jtitton/RC-Light-Controller/LuzesArduino_Producao/LuzesArduino_Producao.ino

/*
 * ============================================================
 *  Sistema de Luzes para Carro RC - v8.4 (Versão PRODUÇÃO / PISTA)
 *  Arduino Nano + Receptor FlySky FS-BS6 + Acelerômetro MPU-6050
 * ============================================================
 *
 * Esta versão é 100% focada em PERFORMANCE MÁXIMA NA PISTA:
 *   - Zero comunicação Serial (sem desperdício de ciclos de CPU ou interrupções de UART).
 *   - Suporte a Acelerômetro I2C MPU-6050 nos pinos A4 (SDA) e A5 (SCL) a 400kHz.
 *   - Auto-Alinhamento Vetorial 3D (independente da orientação de montagem).
 *   - Alerta de Capotamento (Roll-Over Safety): 4 piscas piscam rápido em alerta.
 *   - Loop otimizado rodando entre 1.000 Hz e 2.000 Hz com MPU ativo (~20.000–30.000 Hz em fallback sem sensor).
 *   - Inicialização e Calibração 100% autônomas via rádio guiadas por LEDs.
 *
 * Entradas (Servo PPM do receptor):
 *   D4 - Volante / Direção (CH1, Pin Change Interrupt PCINT20)
 *   D2 - Acelerador / Freio (CH2, Interrupção externa INT0)
 *   D3 - Farol (CH4, Interrupção externa INT1)
 *   5V / GND - Alimentação direta via Canal 6 (CH6 do receptor)
 *
 * Interface I2C:
 *   A4 (SDA) - Dados I2C do MPU-6050 (GY-521)
 *   A5 (SCL) - Clock I2C do MPU-6050 (GY-521)
 *
 * Saídas (LEDs):
 *   D5  - Lanterna traseira (vermelho, PWM com fade suave de ~300ms)
 *   D6  - Luz de freio (vermelho, PWM com fade suave de ~300ms)
 *   D9  - Farol dianteiro (branco via Q1, PWM com fade suave: OFF / 40% / 100%)
 *   D10 - Pisca dianteiro esquerdo (laranja, Digital)
 *   D11 - Pisca dianteiro direito (laranja, Digital)
 *   D7  - Pisca traseiro esquerdo (laranja, Digital)
 *   D8  - Pisca traseiro direito (laranja, Digital)
 */

#include <EEPROM.h>
#include <Wire.h>

// ============================================================
// PINAGEM
// ============================================================
#define PIN_IN_STEERING    4    // CH1 - Volante (PCINT20)
#define PIN_IN_THROTTLE    2    // CH2 - Aceleração (INT0)
#define PIN_IN_HEADLIGHT   3    // CH4 - Farol (INT1)

#define PIN_OUT_TAIL       5    // PWM - Lanterna traseira
#define PIN_OUT_BRAKE      6    // PWM/Digital - Luz de freio
#define PIN_OUT_HEADLIGHT  9    // PWM - Farol dianteiro
#define PIN_OUT_BLINK_FL   10   // Pisca dianteiro esquerdo
#define PIN_OUT_BLINK_FR   11   // Pisca dianteiro direito
#define PIN_OUT_BLINK_RL   7    // Pisca traseiro esquerdo
#define PIN_OUT_BLINK_RR   8    // Pisca traseiro direito

// ============================================================
// CONSTANTES E CONFIGURAÇÕES
// ============================================================
#define EEPROM_MAGIC_VALUE       0xAD
#define EEPROM_START_ADDR        0

#define PPM_VALID_MIN            800
#define PPM_VALID_MAX            2200

#define DEFAULT_CENTER           1500
#define DEFAULT_DEFLECTION       500

// --- Registradores e Constantes MPU-6050 (I2C) ---
#define MPU6050_ADDR_A           0x68
#define MPU6050_ADDR_B           0x69
#define MPU6050_REG_PWR_1        0x6B
#define MPU6050_REG_CONFIG       0x1A
#define MPU6050_REG_ACCEL_CFG    0x1C
#define MPU6050_REG_ACCEL_X      0x3B
#define ACCEL_SCALE_4G           8192.0f
#define ACCEL_BRAKE_THRESH_G     0.20f   // Desaceleração física para acionar freio
#define ACCEL_ROLLOVER_COS       0.15f   // Ângulo > 81° com a vertical indica capotamento

// --- Limiares de Ação (%) ---
#define STEERING_BLINK_PERCENT   70    // Deflexão do volante para ligar o pisca (70%)
#define THROTTLE_BRAKE_PERCENT   5     // Desaceleração PPM para acionar freio (5%)
#define HEADLIGHT_THRESH_LOW     33    // Abaixo: OFF | Acima: 40%
#define HEADLIGHT_THRESH_HIGH    66    // Acima: 100%

// --- Níveis de Brilho (PWM 0-255) ---
#define BRIGHTNESS_OFF           0
#define BRIGHTNESS_40            102
#define BRIGHTNESS_100           255

// --- Pisca e Fade ---
#define BLINK_INTERVAL_MS        250   // 120 bpm
#define BLINK_HAZARD_MS          120   // Pisca-alerta de capotamento
#define FADE_STEP_INTERVAL_MS    6     // Intervalo de fade da lanterna (~300ms total)
#define FADE_STEP_SIZE           5

// --- Filtro de Média Móvel ---
#define FILTER_SIZE              5
#define CAL_MIN_RANGE            200

// ============================================================
// ESTRUTURAS
// ============================================================
struct CalibrationData {
  uint8_t magic;
  int steerDeflLeft;
  int steerDeflRight;
  int throDeflBack;
  int throDeflFwd;
  int headlightMin;
  int headlightMax;
  // Vetor unitário longitudinal de avanço 3D
  float uLongX;
  float uLongY;
  float uLongZ;
};

struct MovingAvgFilter {
  int samples[FILTER_SIZE];
  int index;

  void init(int defaultVal) {
    for (int i = 0; i < FILTER_SIZE; i++) samples[i] = defaultVal;
    index = 0;
  }

  int update(int newValue) {
    samples[index] = newValue;
    index = (index + 1) % FILTER_SIZE;
    return average();
  }

  int average() const {
    long sum = 0;
    for (int i = 0; i < FILTER_SIZE; i++) sum += samples[i];
    return (int)(sum / FILTER_SIZE);
  }
};

enum HeadlightMode { HL_OFF, HL_DIM, HL_FULL };
enum BlinkDirection {
  BLINK_HAZARD = -2,
  BLINK_LEFT   = -1,
  BLINK_NONE   =  0,
  BLINK_RIGHT  =  1
};

// ============================================================
// VARIÁVEIS GLOBAIS
// ============================================================
CalibrationData g_cal;

int g_steerCenter = DEFAULT_CENTER;
int g_throCenter  = DEFAULT_CENTER;

// Acelerômetro I2C & Força G
bool    g_hasMPU           = false;
uint8_t g_mpuAddr          = MPU6050_ADDR_A;
float   g_g0X              = 0.0f;
float   g_g0Y              = 0.0f;
float   g_g0Z              = 1.0f;
float   g_rawAx            = 0.0f;
float   g_rawAy            = 0.0f;
float   g_rawAz            = 1.0f;
float   g_accelLong        = 0.0f;
bool    g_rollOver         = false;
bool    g_longVectorLocked = false;

// ISR variables (volatile)
volatile unsigned long g_steerRiseTime = 0;
volatile unsigned long g_throRiseTime  = 0;
volatile unsigned long g_hlRiseTime    = 0;

volatile int g_steerPulse = DEFAULT_CENTER;
volatile int g_throPulse  = DEFAULT_CENTER;
volatile int g_hlPulse    = DEFAULT_CENTER;

volatile bool g_steerNewPulse = false;
volatile bool g_throNewPulse  = false;
volatile bool g_hlNewPulse    = false;

MovingAvgFilter g_steerFilter;
MovingAvgFilter g_throFilter;
MovingAvgFilter g_hlFilter;

// --- Fade suave dos LEDs (Farol Q1, Lanterna Traseira, Luz de Freio) ---
int           g_tailCurrent        = 0;
int           g_tailTarget         = 0;
unsigned long g_lastFadeUpdate     = 0;

int           g_hlCurrent          = 0;
int           g_hlTarget           = 0;
unsigned long g_lastHlFadeUpdate   = 0;

int           g_brakeCurrent       = 0;
int           g_brakeTarget        = 0;
unsigned long g_lastBrakeFadeUpdate = 0;

unsigned long g_lastBlinkToggle = 0;
bool          g_blinkState      = false;

HeadlightMode g_hlMode = HL_OFF;

// ============================================================
// PROTÓTIPOS
// ============================================================
void throttleISR();
void headlightISR();
int steeringToPercent(int ppm);
int throttleToPercent(int ppm);
int headlightToPercent(int ppm);
void allLEDsOff();
void blinkAllLEDs(int count, int intervalMs);
bool loadCalibration();
void saveCalibration();
void autoCenter();
bool checkCalibrationGesture();
void runFullCalibration();
int getFilteredSteering();
int getFilteredThrottle();
int getFilteredHeadlight();
HeadlightMode calcHeadlightMode(int hlPercent);
bool isBraking(int throPct, float accelLong);
BlinkDirection getBlinkDirection(int steerPct, bool rollOver);
void setHeadlightTarget(HeadlightMode mode);
void updateHeadlightFade();
void setTailLightTarget(HeadlightMode hlMode, bool braking);
void updateTailLightFade();
void setBrakeLightTarget(bool braking);
void updateBrakeLightFade();
void updateBlinkers(BlinkDirection direction);

bool initMPU6050();
bool readMPU6050(float &ax, float &ay, float &az);
void calibrateStaticGravity();
void updateLongitudinalVector(float ax, float ay, float az);
void processInertialDynamics(float ax, float ay, float az);

// ============================================================
// INTERRUPÇÕES
// ============================================================
ISR(PCINT2_vect) {
  if (PIND & (1 << PIN_IN_STEERING)) {
    g_steerRiseTime = micros();
  } else {
    unsigned long pw = micros() - g_steerRiseTime;
    if (pw >= PPM_VALID_MIN && pw <= PPM_VALID_MAX) {
      g_steerPulse = (int)pw;
      g_steerNewPulse = true;
    }
  }
}

void throttleISR() {
  if (PIND & (1 << PIN_IN_THROTTLE)) {
    g_throRiseTime = micros();
  } else {
    unsigned long pw = micros() - g_throRiseTime;
    if (pw >= PPM_VALID_MIN && pw <= PPM_VALID_MAX) {
      g_throPulse = (int)pw;
      g_throNewPulse = true;
    }
  }
}

void headlightISR() {
  if (PIND & (1 << PIN_IN_HEADLIGHT)) {
    g_hlRiseTime = micros();
  } else {
    unsigned long pw = micros() - g_hlRiseTime;
    if (pw >= PPM_VALID_MIN && pw <= PPM_VALID_MAX) {
      g_hlPulse = (int)pw;
      g_hlNewPulse = true;
    }
  }
}

// ============================================================
// DETECÇÃO DE GESTO NO BOOT
// ============================================================
bool checkCalibrationGesture() {
  digitalWrite(PIN_OUT_BLINK_FL, HIGH);
  digitalWrite(PIN_OUT_BLINK_FR, HIGH);

  int steerDeflectedCount = 0;
  int totalSamples = 0;
  unsigned long start = millis();

  // Limpa quaisquer flags pendentes
  noInterrupts();
  g_steerNewPulse = false;
  g_throNewPulse = false;
  interrupts();

  while (millis() - start < 1500) {
    int s = -1;
    noInterrupts();
    if (g_steerNewPulse) {
      s = g_steerPulse;
      g_steerNewPulse = false;
    }
    interrupts();

    if (s >= PPM_VALID_MIN && s <= PPM_VALID_MAX) {
      totalSamples++;
      if (s < 1250 || s > 1750) {
        steerDeflectedCount++;
      }
    }
    delay(10);
  }

  digitalWrite(PIN_OUT_BLINK_FL, LOW);
  digitalWrite(PIN_OUT_BLINK_FR, LOW);

  if (totalSamples >= 15 && steerDeflectedCount >= (totalSamples * 6 / 10)) {
    return true;
  }
  return false;
}

// ============================================================
// SETUP
// ============================================================
void setup() {
  pinMode(PIN_IN_STEERING,  INPUT);
  pinMode(PIN_IN_THROTTLE,  INPUT);
  pinMode(PIN_IN_HEADLIGHT, INPUT);

  pinMode(PIN_OUT_TAIL,      OUTPUT);
  pinMode(PIN_OUT_BRAKE,     OUTPUT);
  pinMode(PIN_OUT_HEADLIGHT, OUTPUT);
  pinMode(PIN_OUT_BLINK_FL,  OUTPUT);
  pinMode(PIN_OUT_BLINK_FR,  OUTPUT);
  pinMode(PIN_OUT_BLINK_RL,  OUTPUT);
  pinMode(PIN_OUT_BLINK_RR,  OUTPUT);

  allLEDsOff();

  g_steerFilter.init(DEFAULT_CENTER);
  g_throFilter.init(DEFAULT_CENTER);
  g_hlFilter.init(DEFAULT_CENTER - DEFAULT_DEFLECTION);

  // Configura interrupções por hardware
  PCICR |= (1 << PCIE2);
  PCMSK2 |= (1 << PCINT20);

  attachInterrupt(digitalPinToInterrupt(PIN_IN_THROTTLE),  throttleISR,  CHANGE);
  attachInterrupt(digitalPinToInterrupt(PIN_IN_HEADLIGHT), headlightISR, CHANGE);

  // Inicializa Acelerômetro MPU-6050
  if (initMPU6050()) {
    calibrateStaticGravity();
  }

  // Carrega calibração prévia ou usa padrões de fábrica (500us)
  if (!loadCalibration()) {
    g_cal.steerDeflLeft  = DEFAULT_DEFLECTION;
    g_cal.steerDeflRight = DEFAULT_DEFLECTION;
    g_cal.throDeflBack   = DEFAULT_DEFLECTION;
    g_cal.throDeflFwd    = DEFAULT_DEFLECTION;
    g_cal.headlightMin   = DEFAULT_CENTER - DEFAULT_DEFLECTION;
    g_cal.headlightMax   = DEFAULT_CENTER + DEFAULT_DEFLECTION;
    g_cal.uLongX         = 1.0f;
    g_cal.uLongY         = 0.0f;
    g_cal.uLongZ         = 0.0f;
  }

  // Verifica gesto de calibração no boot (volante virado por 1.5s)
  bool gesture = checkCalibrationGesture();

  if (gesture) {
    blinkAllLEDs(3, 100); // 3 piscadas confirmam entrada no modo calibração
    delay(400);
    runFullCalibration(); // Executa calibração autônoma guiada por LEDs
  } else {
    autoCenter();
    blinkAllLEDs(2, 100); // 2 piscadas confirmam pronto para rodar
  }
}

// ============================================================
// LOOP PRINCIPAL (Ultra-rápido, não-bloqueante: ~1–2 kHz com MPU, ~20–30 kHz em fallback)
// ============================================================
void loop() {
  int steerRaw = getFilteredSteering();
  int throRaw  = getFilteredThrottle();
  int hlRaw    = getFilteredHeadlight();

  // Lê aceleração inercial se o MPU-6050 estiver presente
  if (g_hasMPU) {
    float ax, ay, az;
    if (readMPU6050(ax, ay, az)) {
      g_rawAx = ax; g_rawAy = ay; g_rawAz = az;
      processInertialDynamics(ax, ay, az);
    }
  }

  int steerPct = steeringToPercent(steerRaw);
  int throPct  = throttleToPercent(throRaw);
  int hlPct    = headlightToPercent(hlRaw);

  // Auto-aprendizado do vetor longitudinal no primeiro avanço forte (>60%)
  if (g_hasMPU && throPct > 60 && !g_longVectorLocked) {
    updateLongitudinalVector(g_rawAx, g_rawAy, g_rawAz);
  }

  g_hlMode = calcHeadlightMode(hlPct);
  bool           braking  = isBraking(throPct, g_accelLong);
  BlinkDirection blinkDir = getBlinkDirection(steerPct, g_rollOver);

  setHeadlightTarget(g_hlMode);
  updateHeadlightFade();
  setTailLightTarget(g_hlMode, braking);
  updateTailLightFade();
  setBrakeLightTarget(braking);
  updateBrakeLightFade();
  updateBlinkers(blinkDir);
}

// ============================================================
// CONVERSÕES PERCENTUAIS
// ============================================================
int steeringToPercent(int ppm) {
  int deviation = ppm - g_steerCenter;
  if (deviation >= 0) {
    if (g_cal.steerDeflRight <= 0) return 0;
    return constrain((int)((long)deviation * 100 / g_cal.steerDeflRight), 0, 100);
  } else {
    if (g_cal.steerDeflLeft <= 0) return 0;
    return constrain((int)((long)deviation * 100 / g_cal.steerDeflLeft), -100, 0);
  }
}

int throttleToPercent(int ppm) {
  int deviation = ppm - g_throCenter;
  if (deviation >= 0) {
    if (g_cal.throDeflFwd <= 0) return 0;
    return constrain((int)((long)deviation * 100 / g_cal.throDeflFwd), 0, 100);
  } else {
    if (g_cal.throDeflBack <= 0) return 0;
    return constrain((int)((long)deviation * 100 / g_cal.throDeflBack), -100, 0);
  }
}

int headlightToPercent(int ppm) {
  int range = g_cal.headlightMax - g_cal.headlightMin;
  if (range <= 0) return 0;
  return constrain((int)((long)(ppm - g_cal.headlightMin) * 100 / range), 0, 100);
}

// ============================================================
// CONTROLE DOS LEDS
// ============================================================
void allLEDsOff() {
  analogWrite(PIN_OUT_HEADLIGHT, 0);
  analogWrite(PIN_OUT_TAIL, 0);
  analogWrite(PIN_OUT_BRAKE, 0);
  digitalWrite(PIN_OUT_BLINK_FL, LOW);
  digitalWrite(PIN_OUT_BLINK_FR, LOW);
  digitalWrite(PIN_OUT_BLINK_RL, LOW);
  digitalWrite(PIN_OUT_BLINK_RR, LOW);
  g_tailCurrent  = 0;
  g_tailTarget   = 0;
  g_hlCurrent    = 0;
  g_hlTarget     = 0;
  g_brakeCurrent = 0;
  g_brakeTarget  = 0;
}

void blinkAllLEDs(int count, int intervalMs) {
  for (int i = 0; i < count; i++) {
    digitalWrite(PIN_OUT_BLINK_FL, HIGH);
    digitalWrite(PIN_OUT_BLINK_FR, HIGH);
    digitalWrite(PIN_OUT_BLINK_RL, HIGH);
    digitalWrite(PIN_OUT_BLINK_RR, HIGH);
    analogWrite(PIN_OUT_HEADLIGHT, BRIGHTNESS_100);
    analogWrite(PIN_OUT_TAIL, BRIGHTNESS_100);
    analogWrite(PIN_OUT_BRAKE, BRIGHTNESS_100);
    delay(intervalMs);
    allLEDsOff();
    delay(intervalMs);
  }
}

int getFilteredSteering() {
  noInterrupts();
  if (g_steerNewPulse) {
    int val = g_steerPulse;
    g_steerNewPulse = false;
    interrupts();
    return g_steerFilter.update(val);
  }
  interrupts();
  return g_steerFilter.average();
}

int getFilteredThrottle() {
  noInterrupts();
  if (g_throNewPulse) {
    int val = g_throPulse;
    g_throNewPulse = false;
    interrupts();
    return g_throFilter.update(val);
  }
  interrupts();
  return g_throFilter.average();
}

int getFilteredHeadlight() {
  noInterrupts();
  if (g_hlNewPulse) {
    int val = g_hlPulse;
    g_hlNewPulse = false;
    interrupts();
    return g_hlFilter.update(val);
  }
  interrupts();
  return g_hlFilter.average();
}

HeadlightMode calcHeadlightMode(int hlPercent) {
  if (hlPercent < HEADLIGHT_THRESH_LOW)  return HL_OFF;
  if (hlPercent < HEADLIGHT_THRESH_HIGH) return HL_DIM;
  return HL_FULL;
}

bool isBraking(int throPct, float accelLong) {
  if (throPct > THROTTLE_BRAKE_PERCENT) return false;
  if (throPct < -THROTTLE_BRAKE_PERCENT) return true;
  if (g_hasMPU && accelLong < -ACCEL_BRAKE_THRESH_G) return true;
  return false;
}

BlinkDirection getBlinkDirection(int steerPct, bool rollOver) {
  if (rollOver) return BLINK_HAZARD;
  if (steerPct <= -STEERING_BLINK_PERCENT) return BLINK_LEFT;
  if (steerPct >=  STEERING_BLINK_PERCENT) return BLINK_RIGHT;
  return BLINK_NONE;
}

void setHeadlightTarget(HeadlightMode mode) {
  switch (mode) {
    case HL_OFF:  g_hlTarget = BRIGHTNESS_OFF; break;
    case HL_DIM:  g_hlTarget = BRIGHTNESS_40;  break;
    case HL_FULL: g_hlTarget = BRIGHTNESS_100; break;
  }
}

void updateHeadlightFade() {
  if (g_hlCurrent == g_hlTarget) return;

  unsigned long now = millis();
  if (now - g_lastHlFadeUpdate < FADE_STEP_INTERVAL_MS) return;
  g_lastHlFadeUpdate = now;

  if (g_hlCurrent < g_hlTarget) {
    g_hlCurrent += FADE_STEP_SIZE;
    if (g_hlCurrent > g_hlTarget) g_hlCurrent = g_hlTarget;
  } else if (g_hlCurrent > g_hlTarget) {
    g_hlCurrent -= FADE_STEP_SIZE;
    if (g_hlCurrent < g_hlTarget) g_hlCurrent = g_hlTarget;
  }
  analogWrite(PIN_OUT_HEADLIGHT, g_hlCurrent);
}

void setTailLightTarget(HeadlightMode hlMode, bool braking) {
  if (braking) {
    g_tailTarget = BRIGHTNESS_100;
  } else if (hlMode != HL_OFF) {
    g_tailTarget = BRIGHTNESS_40;
  } else {
    g_tailTarget = BRIGHTNESS_OFF;
  }
}

void updateTailLightFade() {
  unsigned long now = millis();
  if (now - g_lastFadeUpdate < FADE_STEP_INTERVAL_MS) return;
  g_lastFadeUpdate = now;

  if (g_tailCurrent < g_tailTarget) {
    g_tailCurrent += FADE_STEP_SIZE;
    if (g_tailCurrent > g_tailTarget) g_tailCurrent = g_tailTarget;
  } else if (g_tailCurrent > g_tailTarget) {
    g_tailCurrent -= FADE_STEP_SIZE;
    if (g_tailCurrent < g_tailTarget) g_tailCurrent = g_tailTarget;
  }
  analogWrite(PIN_OUT_TAIL, g_tailCurrent);
}

void setBrakeLightTarget(bool braking) {
  g_brakeTarget = braking ? BRIGHTNESS_100 : BRIGHTNESS_OFF;
}

void updateBrakeLightFade() {
  if (g_brakeCurrent == g_brakeTarget) return;

  unsigned long now = millis();
  if (now - g_lastBrakeFadeUpdate < FADE_STEP_INTERVAL_MS) return;
  g_lastBrakeFadeUpdate = now;

  if (g_brakeCurrent < g_brakeTarget) {
    g_brakeCurrent += FADE_STEP_SIZE;
    if (g_brakeCurrent > g_brakeTarget) g_brakeCurrent = g_brakeTarget;
  } else if (g_brakeCurrent > g_brakeTarget) {
    g_brakeCurrent -= FADE_STEP_SIZE;
    if (g_brakeCurrent < g_brakeTarget) g_brakeCurrent = g_brakeTarget;
  }
  analogWrite(PIN_OUT_BRAKE, g_brakeCurrent);
}

void updateBlinkers(BlinkDirection direction) {
  unsigned long now = millis();
  if (direction == BLINK_NONE) {
    digitalWrite(PIN_OUT_BLINK_FL, LOW);
    digitalWrite(PIN_OUT_BLINK_FR, LOW);
    digitalWrite(PIN_OUT_BLINK_RL, LOW);
    digitalWrite(PIN_OUT_BLINK_RR, LOW);
    g_blinkState = false;
    g_lastBlinkToggle = now;
    return;
  }

  unsigned long interval = (direction == BLINK_HAZARD) ? BLINK_HAZARD_MS : BLINK_INTERVAL_MS;

  if (now - g_lastBlinkToggle >= interval) {
    g_blinkState = !g_blinkState;
    g_lastBlinkToggle = now;
  }

  if (direction == BLINK_HAZARD) {
    digitalWrite(PIN_OUT_BLINK_FL, g_blinkState ? HIGH : LOW);
    digitalWrite(PIN_OUT_BLINK_RL, g_blinkState ? HIGH : LOW);
    digitalWrite(PIN_OUT_BLINK_FR, g_blinkState ? HIGH : LOW);
    digitalWrite(PIN_OUT_BLINK_RR, g_blinkState ? HIGH : LOW);
  } else if (direction == BLINK_LEFT) {
    digitalWrite(PIN_OUT_BLINK_FL, g_blinkState ? HIGH : LOW);
    digitalWrite(PIN_OUT_BLINK_RL, g_blinkState ? HIGH : LOW);
    digitalWrite(PIN_OUT_BLINK_FR, LOW);
    digitalWrite(PIN_OUT_BLINK_RR, LOW);
  } else {
    digitalWrite(PIN_OUT_BLINK_FL, LOW);
    digitalWrite(PIN_OUT_BLINK_RL, LOW);
    digitalWrite(PIN_OUT_BLINK_FR, g_blinkState ? HIGH : LOW);
    digitalWrite(PIN_OUT_BLINK_RR, g_blinkState ? HIGH : LOW);
  }
}

// ============================================================
// ACELERÔMETRO MPU-6050 & VETOR 3D (ZERO SERIAL)
// ============================================================
bool initMPU6050() {
  Wire.begin();
  Wire.setClock(400000);

  g_mpuAddr = MPU6050_ADDR_A;
  Wire.beginTransmission(g_mpuAddr);
  byte error = Wire.endTransmission();

  if (error != 0) {
    g_mpuAddr = MPU6050_ADDR_B;
    Wire.beginTransmission(g_mpuAddr);
    error = Wire.endTransmission();
  }

  if (error != 0) {
    g_hasMPU = false;
    return false;
  }

  Wire.beginTransmission(g_mpuAddr);
  Wire.write(MPU6050_REG_PWR_1);
  Wire.write(0x00);
  Wire.endTransmission();

  Wire.beginTransmission(g_mpuAddr);
  Wire.write(MPU6050_REG_CONFIG);
  Wire.write(0x03);
  Wire.endTransmission();

  Wire.beginTransmission(g_mpuAddr);
  Wire.write(MPU6050_REG_ACCEL_CFG);
  Wire.write(0x08);
  Wire.endTransmission();

  g_hasMPU = true;
  return true;
}

bool readMPU6050(float &ax, float &ay, float &az) {
  if (!g_hasMPU) return false;

  Wire.beginTransmission(g_mpuAddr);
  Wire.write(MPU6050_REG_ACCEL_X);
  if (Wire.endTransmission(false) != 0) return false;

  Wire.requestFrom((uint8_t)g_mpuAddr, (uint8_t)6, (uint8_t)true);
  if (Wire.available() < 6) return false;

  int16_t rawX = (int16_t)(Wire.read() << 8 | Wire.read());
  int16_t rawY = (int16_t)(Wire.read() << 8 | Wire.read());
  int16_t rawZ = (int16_t)(Wire.read() << 8 | Wire.read());

  ax = (float)rawX / ACCEL_SCALE_4G;
  ay = (float)rawY / ACCEL_SCALE_4G;
  az = (float)rawZ / ACCEL_SCALE_4G;
  return true;
}

void calibrateStaticGravity() {
  if (!g_hasMPU) return;
  float sumX = 0, sumY = 0, sumZ = 0;
  int count = 0;
  unsigned long t0 = millis();

  while (millis() - t0 < 800) {
    float ax, ay, az;
    if (readMPU6050(ax, ay, az)) {
      sumX += ax;
      sumY += ay;
      sumZ += az;
      count++;
    }
    delay(10);
  }

  if (count >= 10) {
    g_g0X = sumX / count;
    g_g0Y = sumY / count;
    g_g0Z = sumZ / count;
  } else {
    g_g0X = 0.0f; g_g0Y = 0.0f; g_g0Z = 1.0f;
  }
}

void updateLongitudinalVector(float ax, float ay, float az) {
  float dx = ax - g_g0X;
  float dy = ay - g_g0Y;
  float dz = az - g_g0Z;
  float mag = sqrt(dx * dx + dy * dy + dz * dz);

  if (mag >= 0.25f) {
    g_cal.uLongX = dx / mag;
    g_cal.uLongY = dy / mag;
    g_cal.uLongZ = dz / mag;
    g_longVectorLocked = true;
    saveCalibration();
  }
}

void processInertialDynamics(float ax, float ay, float az) {
  if (!g_hasMPU) {
    g_accelLong = 0.0f;
    g_rollOver  = false;
    return;
  }

  float dx = ax - g_g0X;
  float dy = ay - g_g0Y;
  float dz = az - g_g0Z;
  g_accelLong = (dx * g_cal.uLongX) + (dy * g_cal.uLongY) + (dz * g_cal.uLongZ);

  float gMagAct = sqrt(ax * ax + ay * ay + az * az);
  float gMag0   = sqrt(g_g0X * g_g0X + g_g0Y * g_g0Y + g_g0Z * g_g0Z);

  if (gMagAct > 0.3f && gMag0 > 0.3f) {
    float cosAngle = (ax * g_g0X + ay * g_g0Y + az * g_g0Z) / (gMagAct * gMag0);
    g_rollOver = (cosAngle < ACCEL_ROLLOVER_COS);
  } else {
    g_rollOver = false;
  }
}

// ============================================================
// EEPROM
// ============================================================
bool loadCalibration() {
  EEPROM.get(EEPROM_START_ADDR, g_cal);
  if (g_cal.magic != EEPROM_MAGIC_VALUE) return false;
  if (g_cal.steerDeflLeft < 50 || g_cal.steerDeflRight < 50 ||
      g_cal.throDeflBack < 50  || g_cal.throDeflFwd < 50 ||
      (g_cal.headlightMax - g_cal.headlightMin) < CAL_MIN_RANGE) {
    return false;
  }
  float mag = sqrt(g_cal.uLongX * g_cal.uLongX + g_cal.uLongY * g_cal.uLongY + g_cal.uLongZ * g_cal.uLongZ);
  if (isnan(mag) || mag < 0.5f || mag > 1.5f) {
    g_cal.uLongX = 1.0f;
    g_cal.uLongY = 0.0f;
    g_cal.uLongZ = 0.0f;
    g_longVectorLocked = false;
  } else {
    g_longVectorLocked = true;
  }
  return true;
}

void saveCalibration() {
  g_cal.magic = EEPROM_MAGIC_VALUE;
  EEPROM.put(EEPROM_START_ADDR, g_cal);
}

// ============================================================
// AUTO-CENTRO E CALIBRAÇÃO GUIADA POR LEDS
// ============================================================
void autoCenter() {
  digitalWrite(PIN_OUT_BLINK_FL, HIGH);
  digitalWrite(PIN_OUT_BLINK_FR, HIGH);
  digitalWrite(PIN_OUT_BLINK_RL, HIGH);
  digitalWrite(PIN_OUT_BLINK_RR, HIGH);

  long steerSum = 0, throSum = 0;
  int  samples  = 0;
  unsigned long startTime = millis();

  noInterrupts();
  g_steerNewPulse = false;
  g_throNewPulse = false;
  interrupts();

  while (millis() - startTime < 2000) {
    int sVal = 0, tVal = 0;
    bool gotS = false, gotT = false;

    noInterrupts();
    if (g_steerNewPulse) { sVal = g_steerPulse; g_steerNewPulse = false; gotS = true; }
    if (g_throNewPulse)  { tVal = g_throPulse;  g_throNewPulse  = false; gotT = true; }
    interrupts();

    if (gotS && gotT) {
      steerSum += sVal;
      throSum  += tVal;
      samples++;
    }
    delay(5);
  }

  digitalWrite(PIN_OUT_BLINK_FL, LOW);
  digitalWrite(PIN_OUT_BLINK_FR, LOW);
  digitalWrite(PIN_OUT_BLINK_RL, LOW);
  digitalWrite(PIN_OUT_BLINK_RR, LOW);

  if (samples > 0) {
    g_steerCenter = (int)(steerSum / samples);
    g_throCenter  = (int)(throSum  / samples);
  } else {
    g_steerCenter = DEFAULT_CENTER;
    g_throCenter  = DEFAULT_CENTER;
  }
}

void runFullCalibration() {
  autoCenter();
  if (g_hasMPU) {
    calibrateStaticGravity();
  }
  blinkAllLEDs(2, 150);
  delay(300);

  // --- PASSO 1: EXTREMOS VOLANTE E ACELERADOR (5s) ---
  int sMin = g_steerCenter, sMax = g_steerCenter;
  int tMin = g_throCenter,  tMax = g_throCenter;
  unsigned long startTime = millis();
  bool ledTog = false;
  unsigned long lastLed = 0;

  noInterrupts();
  g_steerNewPulse = false;
  g_throNewPulse = false;
  interrupts();

  while (millis() - startTime < 5000) {
    int s = -1, t = -1;

    noInterrupts();
    if (g_steerNewPulse) { s = g_steerPulse; g_steerNewPulse = false; }
    if (g_throNewPulse)  { t = g_throPulse;  g_throNewPulse  = false; }
    interrupts();

    if (s > 0) { if (s < sMin) sMin = s; if (s > sMax) sMax = s; }
    if (t > 0) {
      if (t < tMin) tMin = t;
      if (t > tMax) tMax = t;
      if (g_hasMPU && (t - g_throCenter) > (g_cal.throDeflFwd / 2)) {
        float ax, ay, az;
        if (readMPU6050(ax, ay, az)) {
          updateLongitudinalVector(ax, ay, az);
        }
      }
    }

    // Piscas alternando esquerda/direita guiam o usuário
    if (millis() - lastLed >= 200) {
      ledTog = !ledTog;
      digitalWrite(PIN_OUT_BLINK_FL, ledTog ? HIGH : LOW);
      digitalWrite(PIN_OUT_BLINK_RL, ledTog ? HIGH : LOW);
      digitalWrite(PIN_OUT_BLINK_FR, ledTog ? LOW  : HIGH);
      digitalWrite(PIN_OUT_BLINK_RR, ledTog ? LOW  : HIGH);
      lastLed = millis();
    }
    delay(5);
  }
  allLEDsOff();

  g_cal.steerDeflLeft  = g_steerCenter - sMin;
  g_cal.steerDeflRight = sMax - g_steerCenter;
  g_cal.throDeflBack   = g_throCenter  - tMin;
  g_cal.throDeflFwd    = tMax - g_throCenter;

  if (g_cal.steerDeflLeft + g_cal.steerDeflRight < CAL_MIN_RANGE) {
    g_cal.steerDeflLeft  = DEFAULT_DEFLECTION;
    g_cal.steerDeflRight = DEFAULT_DEFLECTION;
  }
  if (g_cal.throDeflBack + g_cal.throDeflFwd < CAL_MIN_RANGE) {
    g_cal.throDeflBack   = DEFAULT_DEFLECTION;
    g_cal.throDeflFwd    = DEFAULT_DEFLECTION;
  }

  blinkAllLEDs(2, 150);
  delay(300);

  // --- PASSO 2: FAROL (5s) ---
  g_cal.headlightMin = PPM_VALID_MAX;
  g_cal.headlightMax = PPM_VALID_MIN;

  analogWrite(PIN_OUT_HEADLIGHT, BRIGHTNESS_40);

  noInterrupts();
  g_hlNewPulse = false;
  interrupts();

  startTime = millis();
  while (millis() - startTime < 5000) {
    int h = -1;

    noInterrupts();
    if (g_hlNewPulse) { h = g_hlPulse; g_hlNewPulse = false; }
    interrupts();

    if (h > 0) {
      if (h < g_cal.headlightMin) g_cal.headlightMin = h;
      if (h > g_cal.headlightMax) g_cal.headlightMax = h;
    }

    // Farol pulsando suavemente avisa para mexer na chave
    int bright = (millis() / 4) % 255;
    if (bright > 127) bright = 255 - bright;
    analogWrite(PIN_OUT_HEADLIGHT, bright);
    delay(5);
  }
  allLEDsOff();

  if (g_cal.headlightMax - g_cal.headlightMin < CAL_MIN_RANGE) {
    g_cal.headlightMin = DEFAULT_CENTER - DEFAULT_DEFLECTION;
    g_cal.headlightMax = DEFAULT_CENTER + DEFAULT_DEFLECTION;
  }

  saveCalibration();
  blinkAllLEDs(5, 100); // 5 piscadas rápidas confirmam gravação na EEPROM
}
