jtitton/RC-Light-Controller/(commit log)

2026-08-29 feat: release v2.0 - dual firmware, standalone gesture calibration, timed keyboard simulation, and full bilingual documentation
2026-08-29 feat: release v6.0 - dual firmware architecture, standalone gesture calibration, timed keyboard simulation, and full bilingual documentation
2026-09-05 feat: integrate Wokwi simulation support and update project documentation and board schematics
2026-09-10 feat: upgrade board layout to v8.4 with 6V BEC support, Q1 headlight driver, and standardized 100Ω resistors.
2026-09-11 feat: implement production-ready RC lighting system with MPU-6050 accelerometer support and optimized ISR loops
